JosephBrooksbank/CapacitiveLedFadeTiny/PCB/CapacitiveLedFadeTiny/CapacitiveLedFadeTiny.step

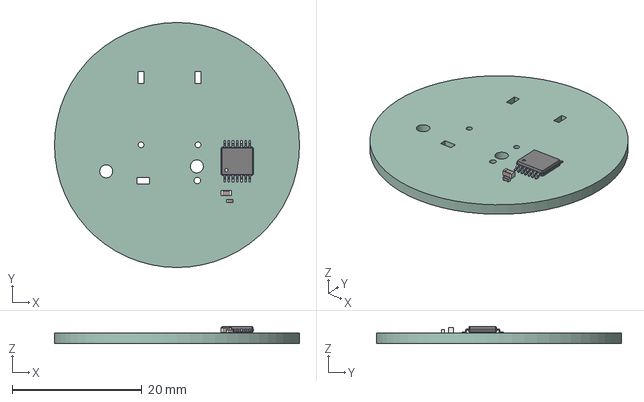
[picture p1: CAD file, 2025-03-13]
PCB/CapacitiveLedFadeTiny/CapacitiveLedFadeTiny.step
37.8 x 37.8 x 2.65 mm
CapacitiveLedFadeTiny PCB
