JosephBrooksbank/CapacitiveLedFadeTiny/PCB/CapacitiveLedFadeTiny/CapacitiveLedFadeTiny_holes.step

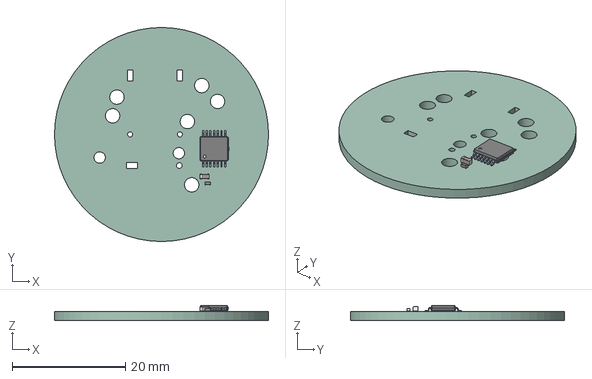
[picture p2: CAD file, 2025-03-13]
PCB/CapacitiveLedFadeTiny/CapacitiveLedFadeTiny_holes.step
37.8 x 37.8 x 2.65 mm
_autosave-CapacitiveLedFadeTiny PCB
