JosephBrooksbank/CapacitiveLedFadeTiny/PCB/CapacitiveLedFadeTiny/CapacitiveLedFadeTiny.kicad_pcb

## KiCad design PCB/CapacitiveLedFadeTiny/CapacitiveLedFadeTiny.kicad_pcb (2025-02-20)

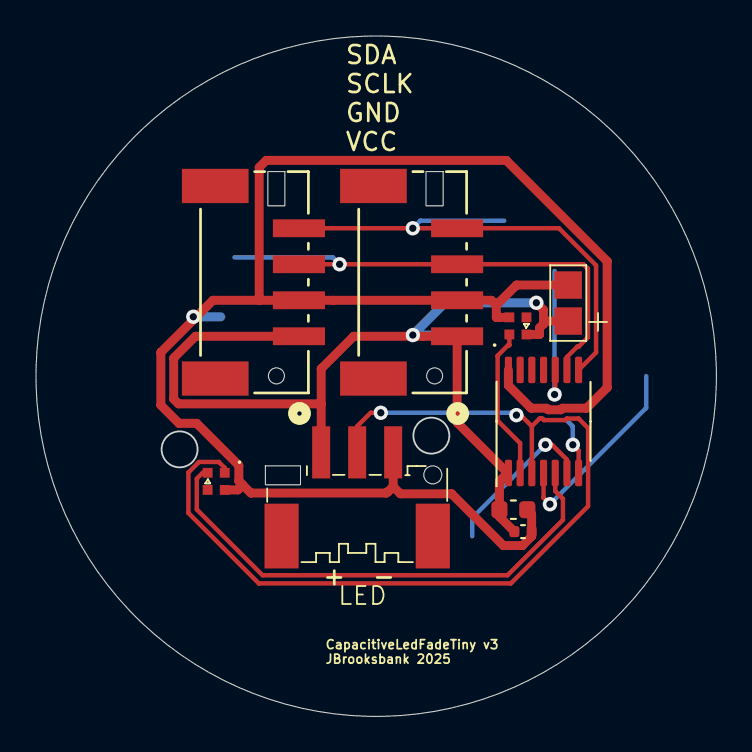
[picture p3: board CapacitiveLedFadeTiny.kicad_pcb from above]

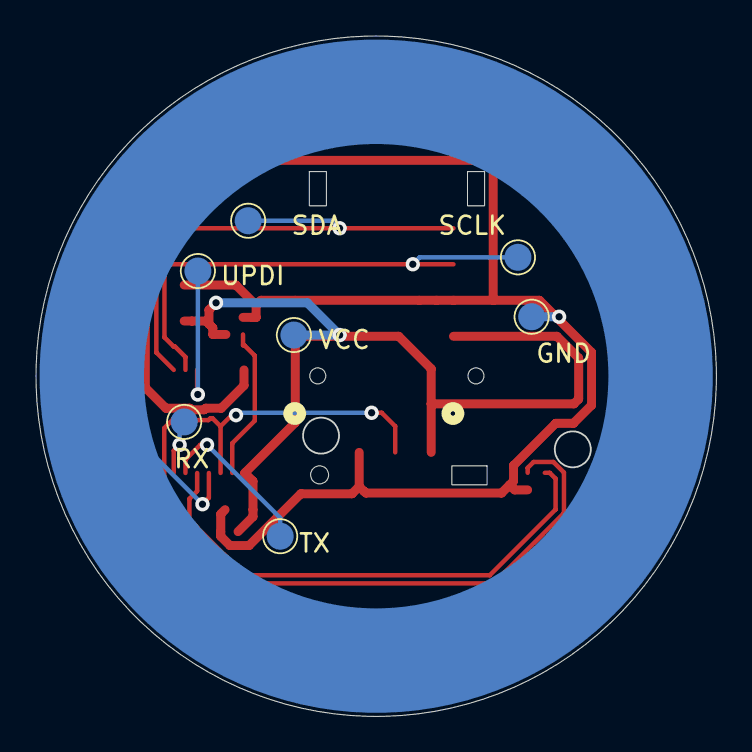
[picture p4: board CapacitiveLedFadeTiny.kicad_pcb from below]

Board: 2 copper layers, 37.8 x 37.8 mm, 17 parts (7 on the bottom side), 11 nets.

Parts:
BusIn1: Bus In; CONN_BM04B-PASS-1-TFTLFSN_JST
BusOut1: Bus Out; CONN_BM04B-PASS-1-TFTLFSN_JST
C3: 0.1uf; C_0402_1005Metric
C4: 1uf; C_0603_1608Metric
GND: GND; TestPoint_Pad_1.5mm_circular
J1: Antenna; CapacitiveAntenna
J6: Power Inject; 2Pad
LED: LEDs; BM03B-PASS-1-TFT
LED1, LED2: SK6805-EC15
RX: PadRX; TestPoint_Pad_1.5mm_circular
SCLK: SCLK; TestPoint_Pad_1.5mm_circular
SDA: SDA; TestPoint_Pad_1.5mm_circular
TX: PadTX; TestPoint_Pad_1.5mm_circular
U1: ATtiny3224-X; TSSOP-14_4.4x5mm_P0.65mm
UPDI: PadUPDI; TestPoint_Pad_1.5mm_circular
VCC: VCC; TestPoint_Pad_1.5mm_circular

Connections:
/LED_Signal: LED.2, LED1.1 (DIN), U1.3 (PA5)
/RX: RX.1, U1.7 (PB2)
/SCLK: BusIn1.3, BusOut1.3, SCLK.1, U1.9 (PB0)
/SDA: BusIn1.4, BusOut1.4, SDA.1, U1.8 (PB1)
/TX: TX.1, U1.6 (PB3)
/UPDI: U1.10 (~RESET/PA0), UPDI.1
GND: BusIn1.2, BusOut1.2, C3.2, C4.2, GND.1, J6.2, LED.3, LED1.4 (GND), LED2.4 (GND), U1.14 (GND)
unnamed: J1.1, U1.4 (PA6)
unnamed: LED1.2 (VDD), U1.5 (PA7)
unnamed: LED2.1 (DIN), U1.2 (PA4)
VCC: BusIn1.1, BusOut1.1, C3.1, C4.1, J6.1, LED.1, LED2.2 (VDD), U1.1 (VCC), VCC.1
