JosephBrooksbank/CapacitiveLedFadeTiny/PCB/ProgrammerTiny/ProgrammerTiny/ProgrammerTiny.kicad_pcb

## KiCad design PCB/ProgrammerTiny/ProgrammerTiny/ProgrammerTiny.kicad_pcb (2024-10-12)

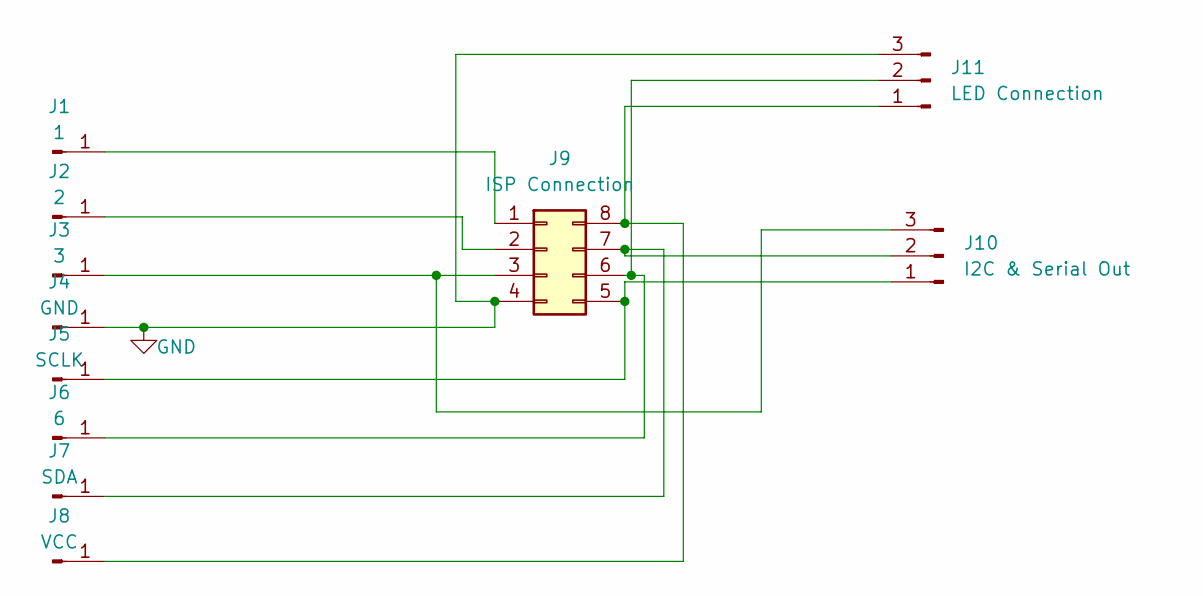
[picture p5: schematic ProgrammerTiny.kicad_sch]

Parts:
J1: 1; P75-E2 Through Hole
J2: 2; P75-E2 Through Hole
J3: 3; P75-E2 Through Hole
J4: GND; P75-E2 Through Hole
J5: SCLK; P75-E2 Through Hole
J6: 6; P75-E2 Through Hole
J7: SDA; P75-E2 Through Hole
J8: VCC; P75-E2 Through Hole
J9: ISP Connection; PinHeader_2x04_P2.54mm_Horizontal
J10: I2C & Serial Out; PinHeader_1x03_P2.54mm_Horizontal
J11: LED Connection; PinHeader_1x03_P2.54mm_Horizontal

Connections:
GND: J4.1, J9.4, J11.3
unnamed: J1.1, J9.1
unnamed: J2.1, J9.2
unnamed: J5.1, J9.5, J10.1
unnamed: J7.1, J9.7, J10.2
unnamed: J3.1, J9.3, J10.3
unnamed: J8.1, J9.8, J11.1
unnamed: J6.1, J9.6, J11.2

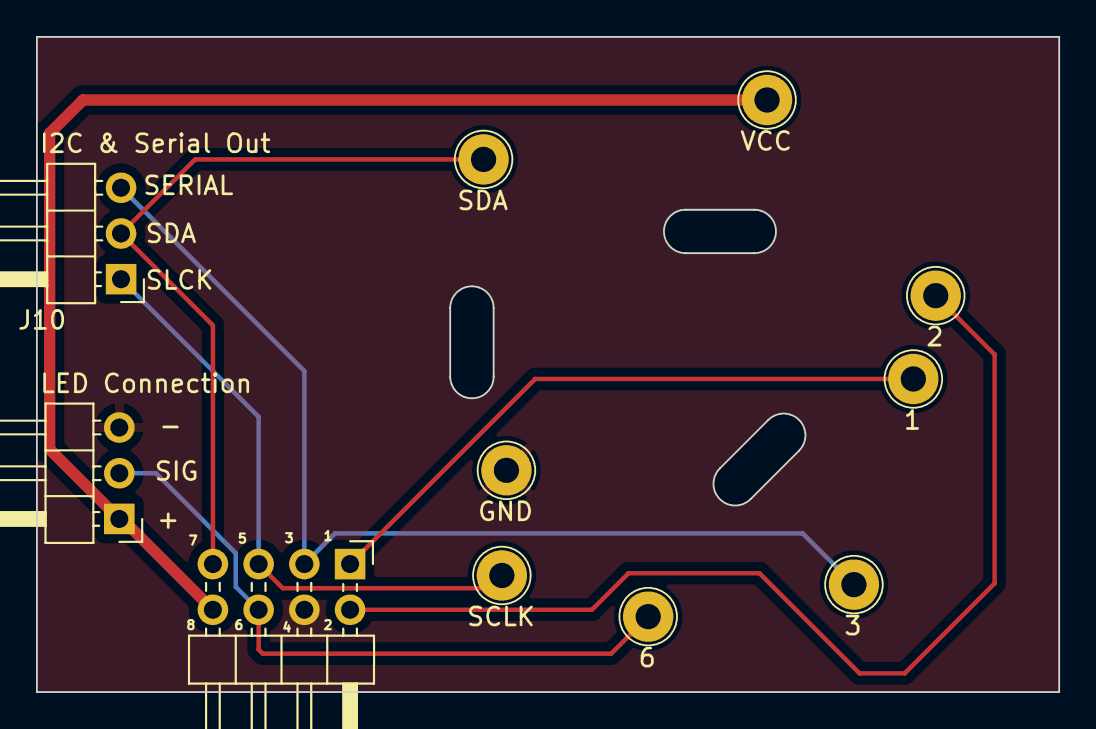
[picture p6: board ProgrammerTiny.kicad_pcb from above]

Board: 2 copper layers, 56.8 x 36.4 mm, 11 parts (0 on the bottom side), 8 nets.
