JosephBrooksbank/CapacitiveLedFadeTiny/Shared/config.h

#ifndef CONFIG_H
#define CONFIG_H

#include "Arduino.h"
#include "FastLED.h"


#define CONFIG_EEPROM_ADDRESS 0
enum ColorMode {
    Single,
    Random,
    Rainbow
};

struct Config {
    // which version of the config is stored in eeprom, for updating defaults
    bool should_store;
    // how large a value needs to be detected before registering as 'touch'
    uint8_t touch_sense;
    // how many ticks without a touch before registering as not a 'touch' (smooth the output, and add a delay off)
    uint8_t off_delay;
    // max brightness of the strip
    uint8_t max_brightness;
    // what animation (solid color, random, rainbow) to display
    ColorMode color_mode;
    // when in single solid color, what color to display
    CRGB single_color_color;
    // how much to decrement brightness every animationTick - larger = faster off
    uint8_t fade_amount;
    // the starting/current hue when in rainbow mode - can be set while in rainbow mode to keep in sync
    uint8_t hue;
}; 

#define RESET_CONFIG true
///// RUNTIME CONFIG (set in EEPROM)
#define DEFAULT_SHOULD_STORE false
#define DEFAULT_TOUCH_SENSE 5
#define DEFAULT_OFF_DELAY 200
#define DEFAULT_MAX_BRIGHTNESS 10
#define DEFAULT_COLOR_MODE Rainbow
#define DEFAULT_SINGLE_COLOR CRGB::White
#define DEFAULT_FADE_AMOUNT 1
#define DEFAULT_HUE 100

Config get_config();
void set_config(Config &conf);
Config setup_config();


///// CONST CONFIG (no change at runtime)
#define BAUD_RATE 115200
#define NUM_LEDS 30
#define ENABLE_DEBUG_LED_PIN PIN_PA7
#define STATUS_PIN PIN_PA4
#define SENSE_PIN PIN_PA6
#define LED_DRIVER WS2812
#define LED_PIN PIN_PA5
// i2c stuff
#define USE_I2C
#define I2C_ADDRESS 21


// Software Serial Stuff
#ifndef USE_I2C
    #define USE_SOFTWARE_SERIAL
    #define SOFTWARE_BAUD 9600
    #define RX_PIN PIN_PB0
    #define TX_PIN PIN_PB1
#endif


#define USE_ONBOARD_LED
#define USE_STATUS_LED


#endif
