JosephBrooksbank/CapacitiveLedFadeTiny/CapacitiveLedFadeTiny/include/I2CLedControl.hpp

//
// Created by joebr on 10/30/2024.
//


#include "Arduino.h"
#include "config.h"

class I2CLedControl {
public:
    explicit I2CLedControl();
    static void setup();
    void onReceive(int bytesReceived);
    void onRequest() const;
    static void writeInt(int value);
    byte* getBuffer();
    bool messageReceived = false;

private:
    uint8_t messageLength = 0;
    byte buffer[BUFFER_SIZE]{};
    static I2CLedControl *instance;
protected:
    static void receiveEventWrapper(int bytesReceived);
    static void requestEventWrapper();
};
