JosephBrooksbank/CapacitiveLedFadeTiny/(commit log)

2024-09-12 Initial Commit
    Sets up Tiny (Target) board with LED and Software based serial
    Sets up Arduino Mega (Controller) as serial interpreter
2024-09-13 Add LED control, config file, conditional serial
2024-10-05 Create PCB
    [CapacitiveLedFadeTiny-B_Cu.gbr, CapacitiveLedFadeTiny-B_Mask.gbr, CapacitiveLedFadeTiny-B_Paste.gbr, CapacitiveLedFadeTiny-B_Silkscreen.gbr, CapacitiveLedFadeTiny-Edge_Cuts.gbr, CapacitiveLedFadeTiny-F_Cu.gbr, CapacitiveLedFadeTiny-F_Mask.gbr, CapacitiveLedFadeTiny-F_Paste.gbr]
2024-10-07 Update board layout
    the attiny is actually a wider footprint :kms:
    this is why we do prototype boards
    [CapacitiveLedFadeTiny.kicad_pcb, CapacitiveLedFadeTiny.kicad_sch]
2024-10-12 v2 of I2C board
    [CapacitiveLedFadeTiny.kicad_pcb, CapacitiveLedFadeTiny.kicad_sch]
2024-10-12 Add programmer board for v2
    [CapacitiveLedFadeTiny-B_Cu.gbr, CapacitiveLedFadeTiny-B_Mask.gbr, CapacitiveLedFadeTiny-B_Paste.gbr, CapacitiveLedFadeTiny-B_Silkscreen.gbr, CapacitiveLedFadeTiny-Edge_Cuts.gbr, CapacitiveLedFadeTiny-F_Cu.gbr, CapacitiveLedFadeTiny-F_Mask.gbr, CapacitiveLedFadeTiny-F_Paste.gbr]
2024-10-28 Idea files
    I'm so tired of this shit
2024-11-01 move led module down one level in repo
2024-11-03 Move some things out to classes, i2c working as echo
2024-11-03 Read led strip status via i2c
2024-11-03 Read LED status via i2c, control board
2024-11-05 send commands to main board via serial
2024-11-06 work more on getting i2c working
    sending the global 'r' command on basically every cycle was _not_ helping and was overwriting other one-off commands like color changes
    I'm not sure if `setWireTimeout` really does much but it doesno seem to hurt
2024-11-06 add more user commands
    some _extremely_ messy code here to try more structures out for sending display commands from the arduino to the led modules. My current goal is a 'splash' pattern out from the point of contact- the cell being touched brightens until it is close to full brightness, at which point the surrounding ones start, repeat.
    I think to do this in a way that looks nice I won't be able to sequentially tell each cell to start fading on, since there may be upwards of 10 outer cells trying to turn on at the same time. Instead I'll need to start telling the next ring to prepare to turn on while fading on the prior ring, and use a global message to start them all.
    Other thoughts:
    per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
    [main.cpp]
2024-11-17 this shit is not working
    [config.h, main.cpp]
2024-12-07 begin work on refactor
    I figured out how to get FastLED to work in other files. Taking another shot at splitting out the code into their own classes, because the original main was impossible to work with after not touching it for a couple of days.
2024-12-08 Add LedBehavior controller, animation modes, send context over i2c
2024-12-10 add AddressMap to track status of other modules
2024-12-10 Add Commands for setting mode and setting other device state
2024-12-15 Begin work to allow timing groups set over i2c
2024-12-16 minor improvements to stack memory while getting timinggroup from i2c
2024-12-16 Start work with EEPROM
    going to move all config values to EEPROM. They shouldn't be changing very often, this way the changes will persist across reboots, and we'll be able to have a bunch more timing groups without worrying about stack overflows. That's the plan, at least
    [main.cpp]
2024-12-17 begin moving config values to eeprom
    these values _can_ change, but likely won't change very often. So can't be flash, but we can save RAM by moving them to EEPROM
    [config.h]
2025-02-19 v3 pcb
    [CapacitiveLedFadeTiny.kicad_pcb]
2025-02-19 pcb v3.1
    [CapacitiveLedFadeTiny.kicad_pcb, CapacitiveLedFadeTiny.kicad_sch]
2025-02-20 v3.2 pcb, changed to PA connectors
    [CapacitiveLedFadeTiny.kicad_pcb, CapacitiveLedFadeTiny.kicad_sch]
2025-03-13 v3 pcb again?
    [CapacitiveLedFadeTiny.step, CapacitiveLedFadeTiny_holes.step]
2025-03-13 v3 code begins
    cleaned up most of it, really don't need a lot of it for the final goal. Todo still:
    - store config values in EEPROM
    - i2c to set config values
    - alternate color mode (whole board one color)
2025-03-13 Wire working
    also optional software serial as a backup
2025-03-13 add windows env, dont track vscode folder
2025-03-16 store variable config values in EEPROM, accept over i2c
    so much easier than expected lol
2025-03-17 set scl manually
    the default wire frequency setting method does not make use of the prescaler, so extremely slow speeds are not available
2025-03-17 capture various i2c speed data
2025-03-17 wip: fade off animation timer
2025-03-17 fade out LEDs, don't fade status led
2025-03-18 change version to a 'should_save' variable to make writes to eeprom more intentional
    also did some timing study to clock in (this current board) to a steady 60 fps animation timing. Some investigation will need to be done with other boards to see how consistent that is- maybe we'll need to calibrate every animation loop for each board separately if we want them to stay reasonably in sync, maybe not.
    with 'synced rainbow' mode, the config data is being sent many times per second. If this was written to eeprom every time we would wear it down quite quickly.
    sending the entire config object just to update the hue is quite inefficient, but since we're animating at 60fps we can afford to be slo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
